Laoyus/Smart-pick-up/code.png

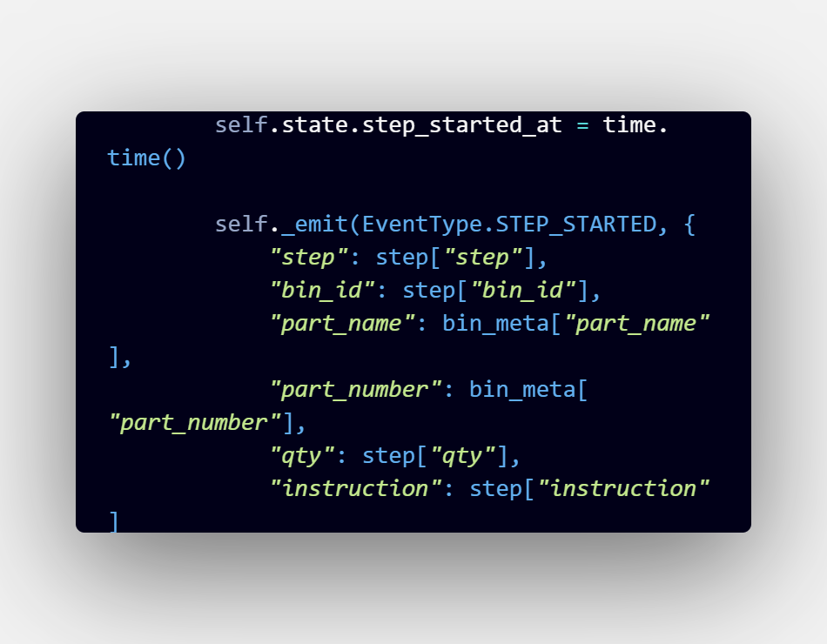
code.png
