Laoyus/Smart-pick-up/(commit log)

2026-05-27 Add fleet management, rerouting, multi-trolley coordinator, and new configs
    [standalone_small_motor.json]
2026-06-19 Add Arduino bridge, hardware backend, and updated pick sequence engine
    - arduino_bridge.ino: IR sensors, HX711 load cells, TM1637 displays, WS2812B
    NeoPixel strips (8 LEDs), active buzzer, emergency stop button; watchdog
    clears outputs on Python disconnect; STREAM command for live weight output;
    IR_CLEARED on beam restore; LED states: white=active, green=correct, red=error
    - arduino_hardware.py: real-hardware backend with weight polling, IR clear
    callbacks, IR state tracking, and over-pick support
    - sequence_engine.py: weight-based real-time countdown display; GREEN LED when
    count hits 0; waits for IR clear before advancing; over-pick detection fires
    red LED + buzzer and logs PIC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
    [app.py, arduino_bridge.ino, arduino_hardware.py, cad_to_json_converter.py, calibrate.ino, fleet_api.py, hardware_abstraction.py, led_test.ino]
2026-06-25 Add WiFi bridge, ESP32 sketches, updated configs and app logic
    [standalone_small_motor.json]
2026-06-25 Remove competition/prototype references from all comments
